norlab-ulaval/imu-benchmark-pcb/README.md

# IMU - benchmark

## IMUs

* [Adafruit 9-DOF LSM9DS0](https://www.adafruit.com/product/2021)
* [Adafruit 6-DOF MPU-6050](https://www.adafruit.com/product/3886)
* [SparkFun 9-DOF ICM-20948](https://www.sparkfun.com/products/15335)

## PCB

[Schematics](./production/schematics.pdf)

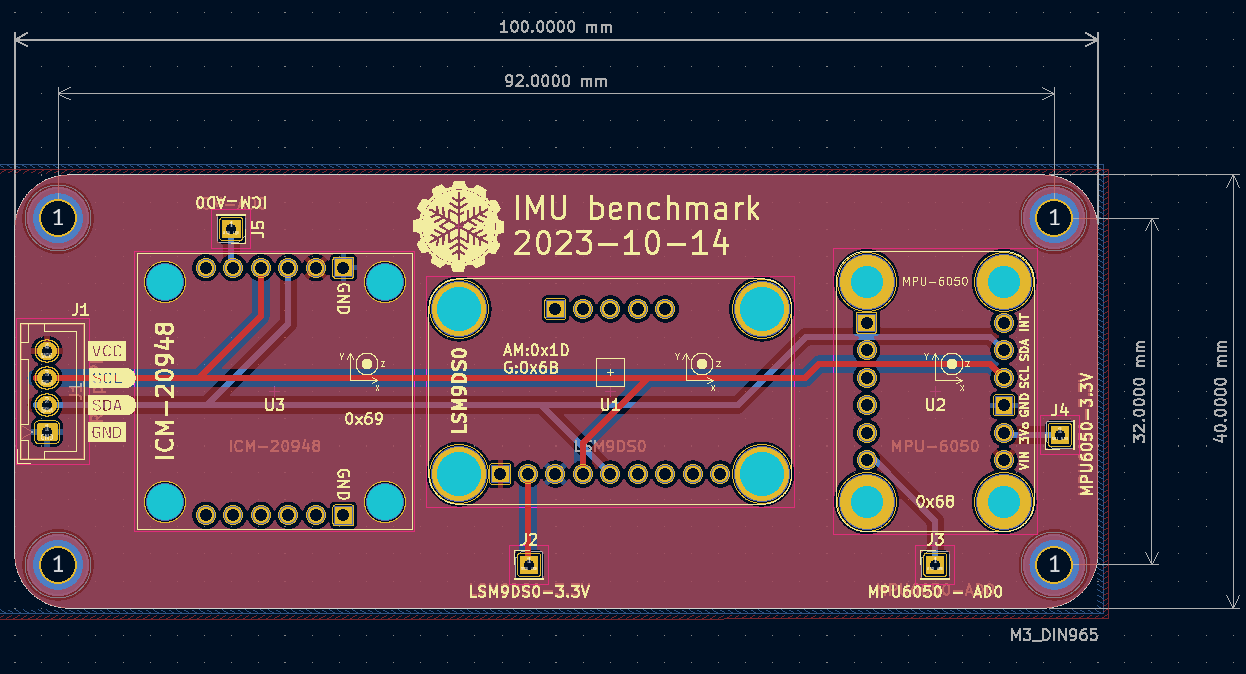
[picture p1: front.png]
Circuit

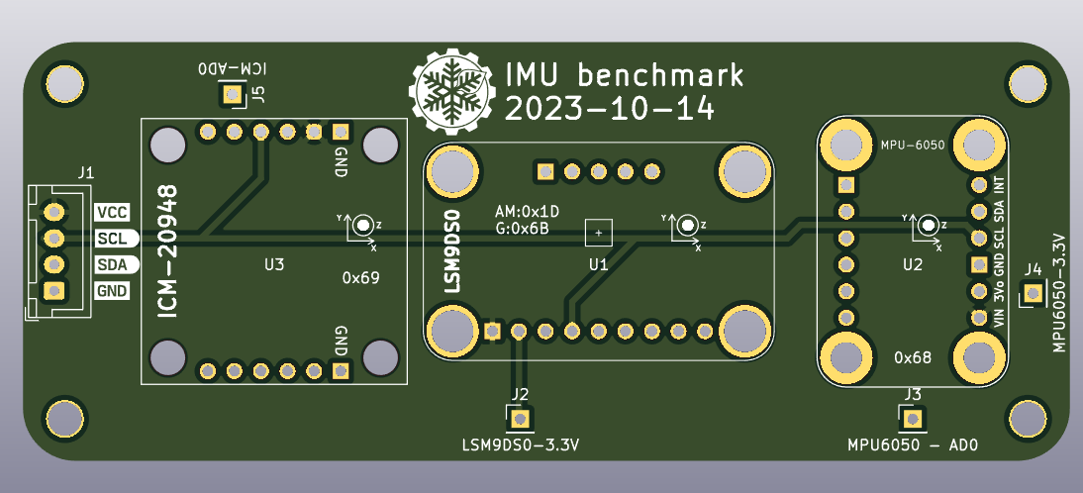
[picture p2: front-3D.png]
Front 3D

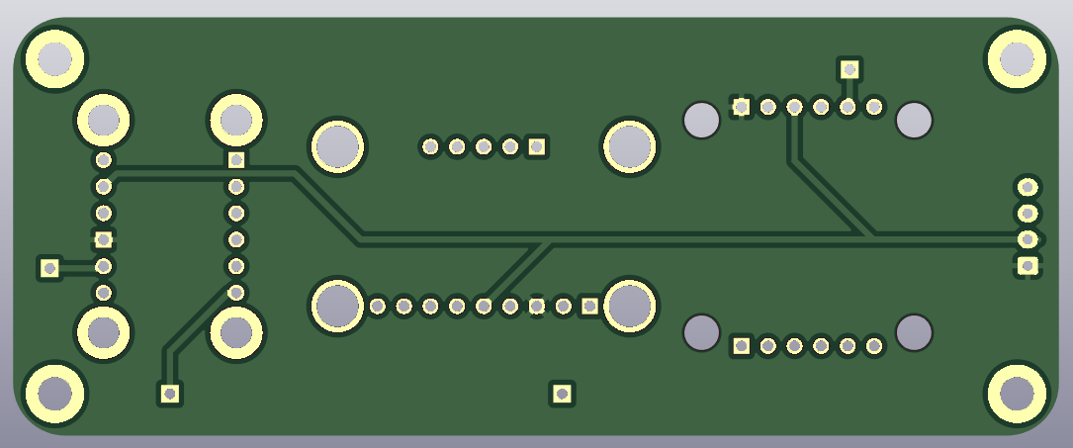
[picture p3: back-3D.png]
Back 3D
