norlab-ulaval/imu-benchmark-pcb/production/IMU_benchmark_2023-10-14_12-37-37/bom.csv

Designator | Footprint | Quantity | Value | LCSC Part #
H1, H2, H3, H4 | MountingHole_3.2mm_M3_DIN965_Pad_TopOnly | 4 | MountingHole
J1 | JST_XH_B4B-XH-A_1x04_P2.50mm_Vertical | 1 | RaspbPi
J2 | PinHeader_1x01_P2.54mm_Vertical | 1 | LSM9DS0-3.3V
J3 | PinHeader_1x01_P2.54mm_Vertical | 1 | MPU6050-AD0
J4 | PinHeader_1x01_P2.54mm_Vertical | 1 | MPU6050-3.3V
J5 | PinHeader_1x01_P2.54mm_Vertical | 1 | ICM-AD0
U1 | Adafruit-2021 | 1 | LSM9DS0
U2 | Adafruit-3886 | 1 | MPU-6050
U3 | SparkFun-ICM-20948 | 1 | ICM-20948
