norlab-ulaval/imu-benchmark-pcb/imu-benchmark.step

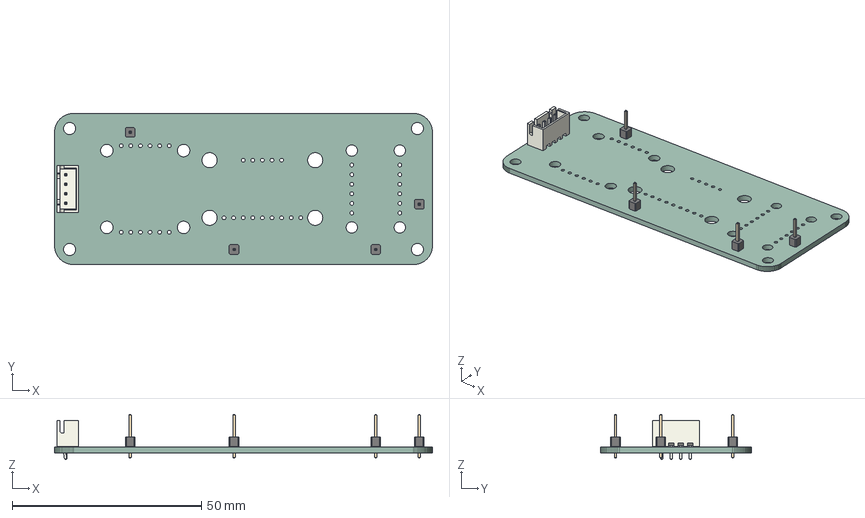
[picture p4: CAD file, 2023-10-30]
imu-benchmark.step
100.0 x 40.0 x 11.9 mm
imu-benchmark PCB
