norlab-ulaval/imu-benchmark-pcb/production/schematics.pdf

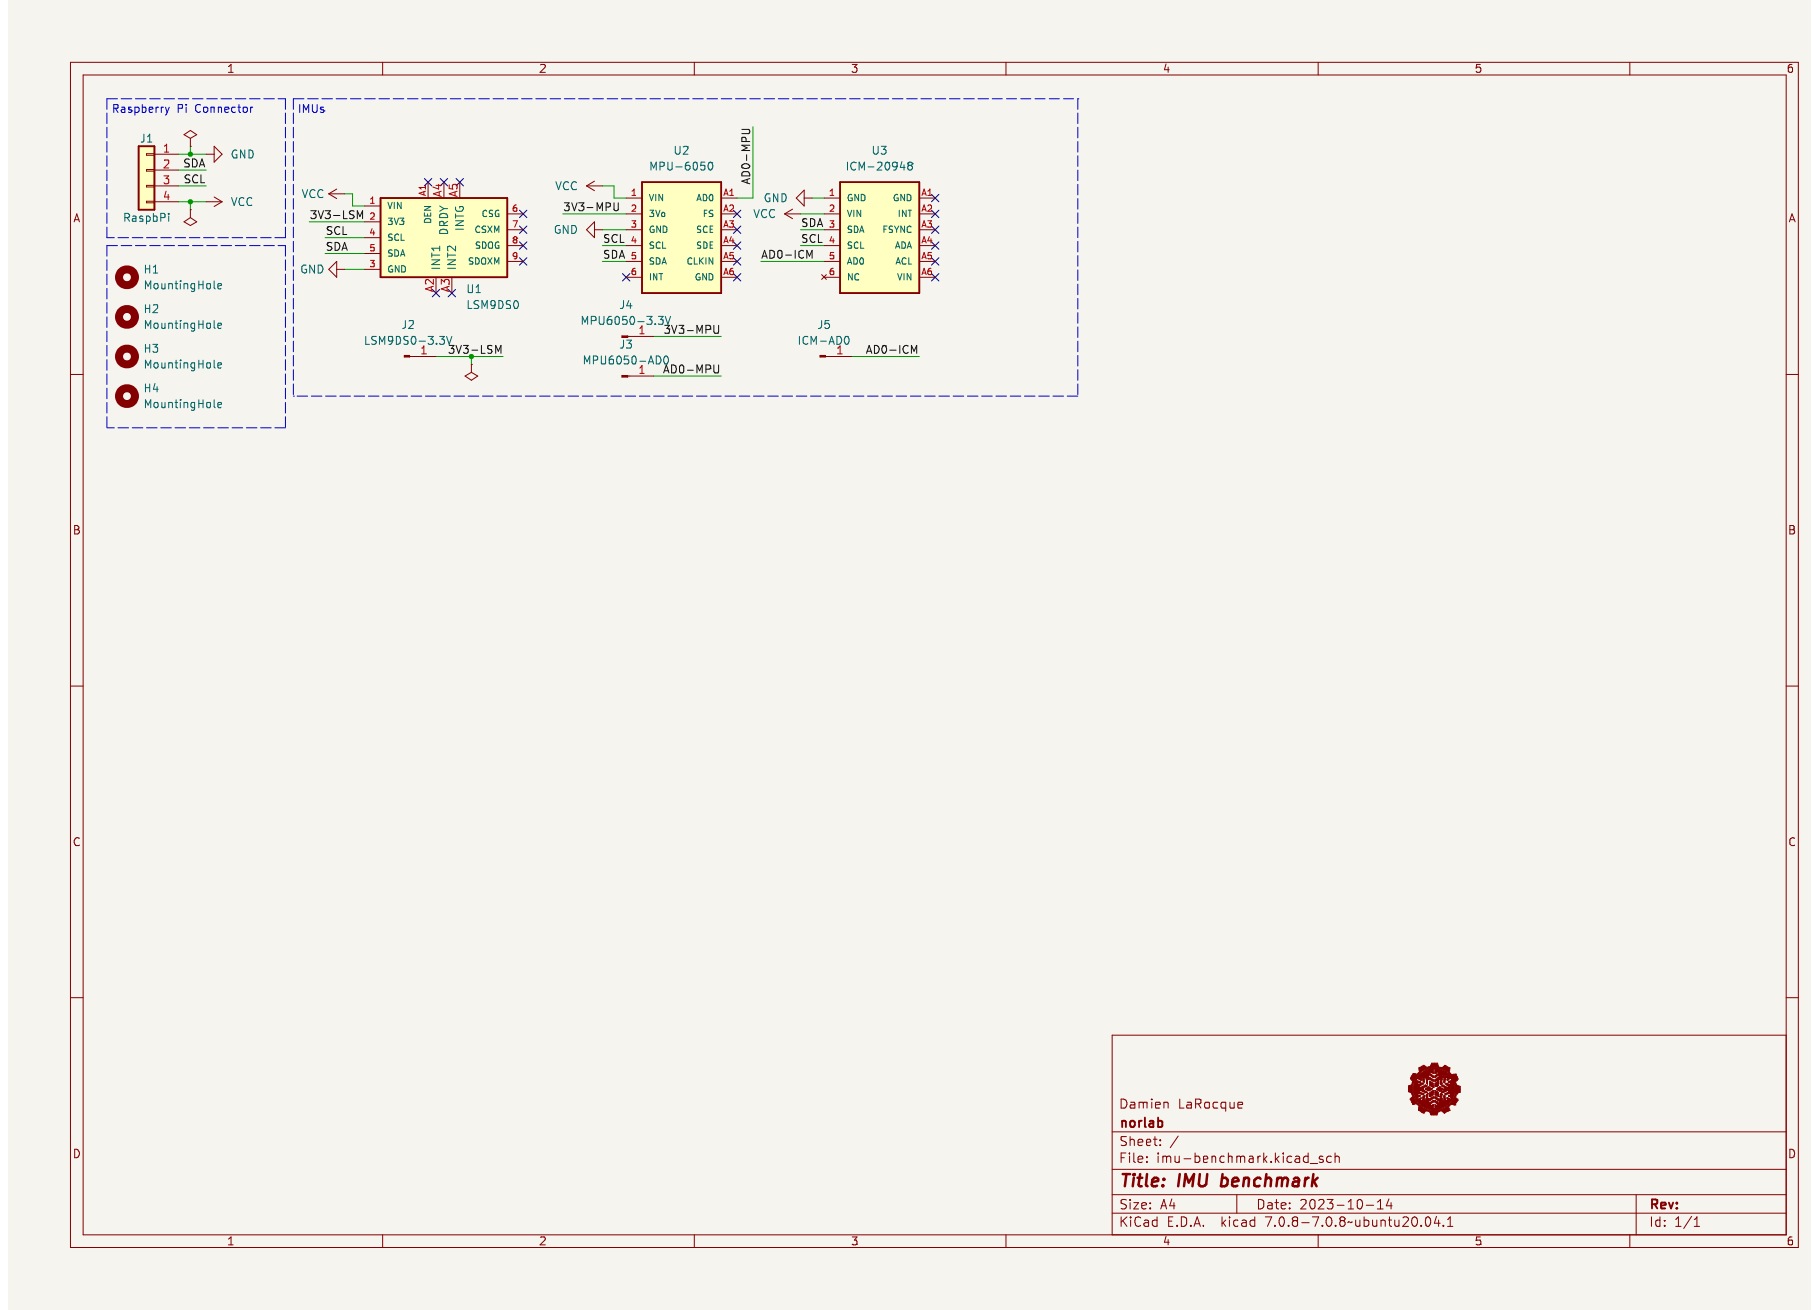
[picture p5: page 1]
