norlab-ulaval/imu-benchmark-pcb/production/layout.pdf

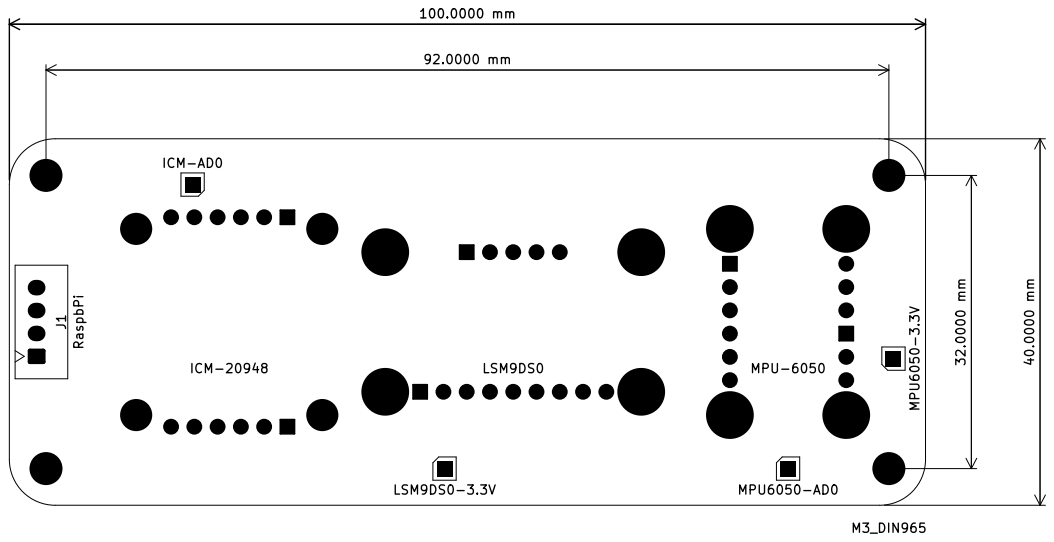
[picture p6: page 1]
