norlab-ulaval/imu-benchmark-pcb/(commit log)

2023-10-13 Format Adafruit 1604 symbol and footprint
2023-10-13 Add Adafruit 2021 and some silkscreen on 1604
2023-10-14 Add axis silkscreen
2023-10-14 Add I2C addresses silkscreens + SparkFun IMU
2023-10-14 Add MPU-6050 symbol and footprint
2023-10-14 Update footprints and add norlab logo
2023-10-14 Layout and route the PCB
    [bom.csv, designators.csv, imu-benchmark.kicad_pcb, imu-benchmark.kicad_sch, positions.csv]
2023-10-14 Fit the PCB in a 100 mm square
    [bom.csv, designators.csv, imu-benchmark.kicad_pcb, positions.csv]
2023-10-14 Export figures and schematics
    [imu-benchmark.kicad_pcb]
2023-10-30 Export STEP file
    [imu-benchmark.kicad_pcb, imu-benchmark.step]
2023-10-30 Use mounting hole as an origin
    [imu-benchmark.kicad_pcb, imu-benchmark.step]
